Misic-Bouhlel/Projet-Arduino/README.md

# Projet-Arduino
Projet Arduino Bouhlel Ziad/Misic Luka
