Misic-Bouhlel/Projet-Arduino/Cahier des charges/Cahier-des-charges.md

Sous-répertoire contenant le cahier des charges
