Misic-Bouhlel/Projet-Arduino/RAPPORT_FINAL_BOUHLEL_MISIC.pdf

MISIC Luka
BOUHLEL Ziad

# Rapport de projet – Arduino

2021-2022

# Smart Breakfast

## Réalisé par : MISIC Luka & BOUHLEL Ziad

## Encadré par : Pascal MASSON

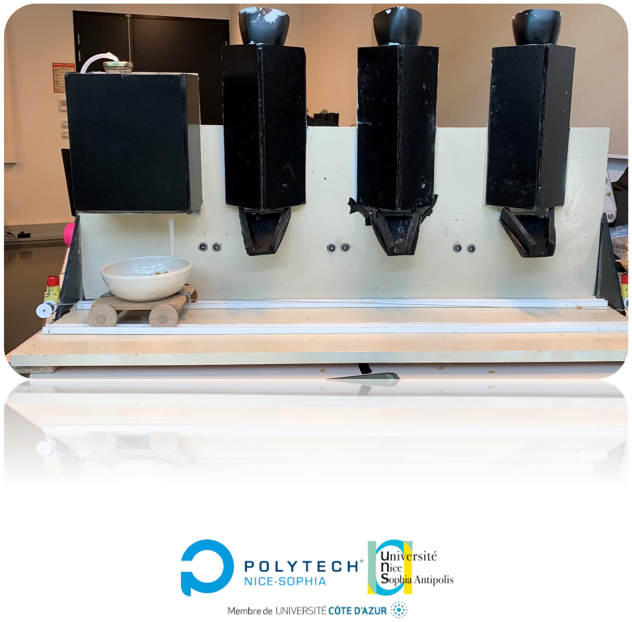
[picture p1: figure]

## SOMMAIRE

## I. Présentation du projet____________________________3

## a) Objectifs et motivations _________________________3

## b) Fonctionnalités : _______________________________3

## c) Matériels utilisés_______________________________3

## II- Réalisation _____________________________________5

## a) Programmation des mécanismes __________________5

## b) Comparaison planning initial/final_________________6

## c) Difficultés rencontrées __________________________7

## III- Conclusion ____________________________________8

## a) Amélioration possible ___________________________8

## b) Apport de ce projet _____________________________9

## I. Présentation du projet

a) Objectifs et motivations

Dans le cadre du parcours de PeiP2, nous avons pu créer un projet Arduino de sa conception à sa réalisation en ayant carte blanche pour le sujet. Le but de ce projet est de se faire une expérience qui nous servira dans le monde professionnel. Cela nous a permis d’évaluer nos compétences sur plusieurs points et d’avoir un regard extérieur sur la façon dont on a réalisé ce projet.

Il arrive à tout le monde de ne pas avoir le temps ni la motivation de préparer son petit-déjeuner alors que ce premier repas de la journée est considéré comme le plus important. On voulait mettre en corrélation l’importance du petit-déjeuner avec notre projet Arduino.

C’est pourquoi nous sommes partis sur l’idée du petit-déjeuner intelligent, l’objectif étant le suivant : réaliser un distributeur de céréales automatisés qui prépare un petit-déjeuner en fonction des choix que l’utilisateur fait sur son smartphone. Ainsi, il n’y a aucun effort à fournir mis à part le choix de son petit-déjeuner.

b) Fonctionnalités :
- Distribution de lait à l’aide d’une pompe
- Déplacement du bol sur des rails sous les diffèrent compartiments
- Distribution de céréales initié par un système de trappe
- Choix de la composition du bol depuis son smartphone par communication Bluetooth avec une application
c) Matériels utilisés

Carte Arduino Mega2560

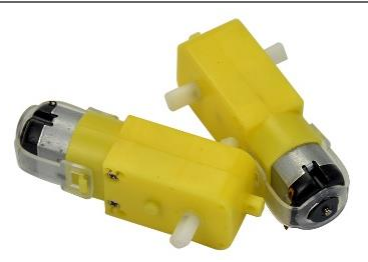
[picture p2: figure]
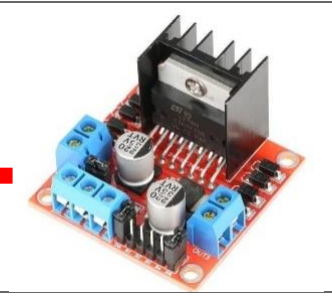
[picture p3: figure]

Moteurs à courant continu + double pont en H : pour le déplacement du bol

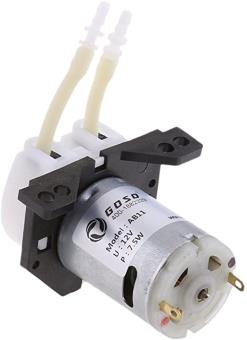
[picture p4: figure]
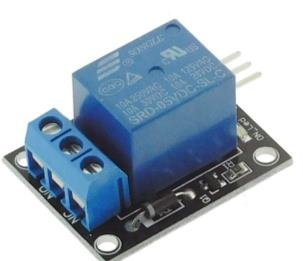
[picture p5: figure]

| Pompe 12V + module relais: pour le versement du lait

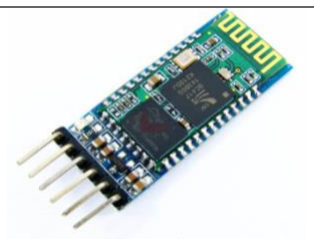
[picture p6: figure]

| Module HC-06 : pour la communication Bluetooth avec le smartphone

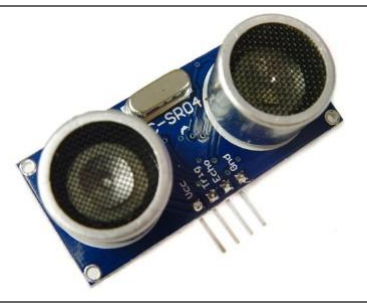
[picture p7: figure]

| Module sonar : pour détecter le bol
| Servomoteurs : pour le versement des céréales
| Alimentation 12V

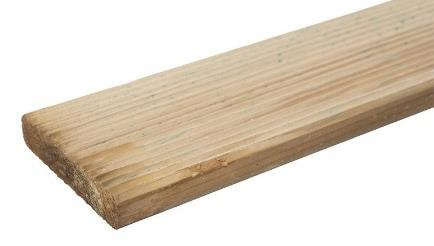
[picture p8: figure]

| Bois : pour la structure, les compartiments

## II- Réalisation

a) Programmation des mécanismes
- Code des servomoteurs :

Pour réaliser le versement des céréales automatiques, il a fallu programmer les servomoteurs afin que leur angle d’ouvertures et de fermeture permettent de d’ouvrir et de recouvrir entièrement la fente sous les compartiments.

- Code de la pompe :

Le relais utilisé nous permet d'activer la pompe pour verser le lait.

- Code du déplacement du bol :

Afin de déplacer le bol sur la structure il a fallu utiliser deux moteurs à courant continu, ils étaient synchronisés pour faire avancer et reculer la plateforme sur laquelle était posé le bol en la tirant par des fils. Lorsqu’un moteur tire, l’autre relâche.

- Code de la communication Bluetooth :

Enfin, pour permettre à l’utilisateur de composer son petit déjeuner sans avoir à manipuler lui-même la structure ou les programmes, nous avons connecté les différents mécanismes à une application sur smartphone : « Bluetooth Electronics ». Pour chaque choix fait sur l’interface, une donnée est envoyée à l’ordinateur qui lui ensuite réalise un enchaînement de conditions déclenchant ou non les mécanismes.

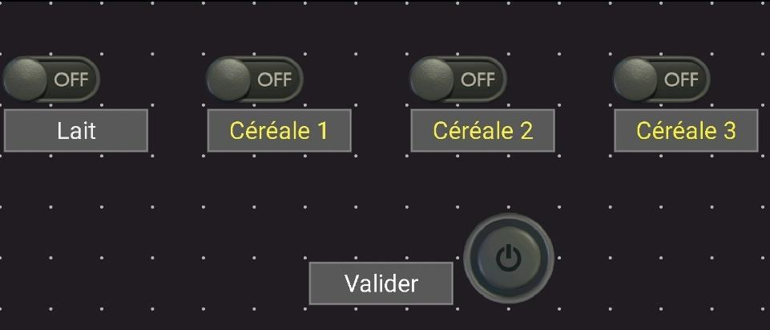
[picture p9: figure]
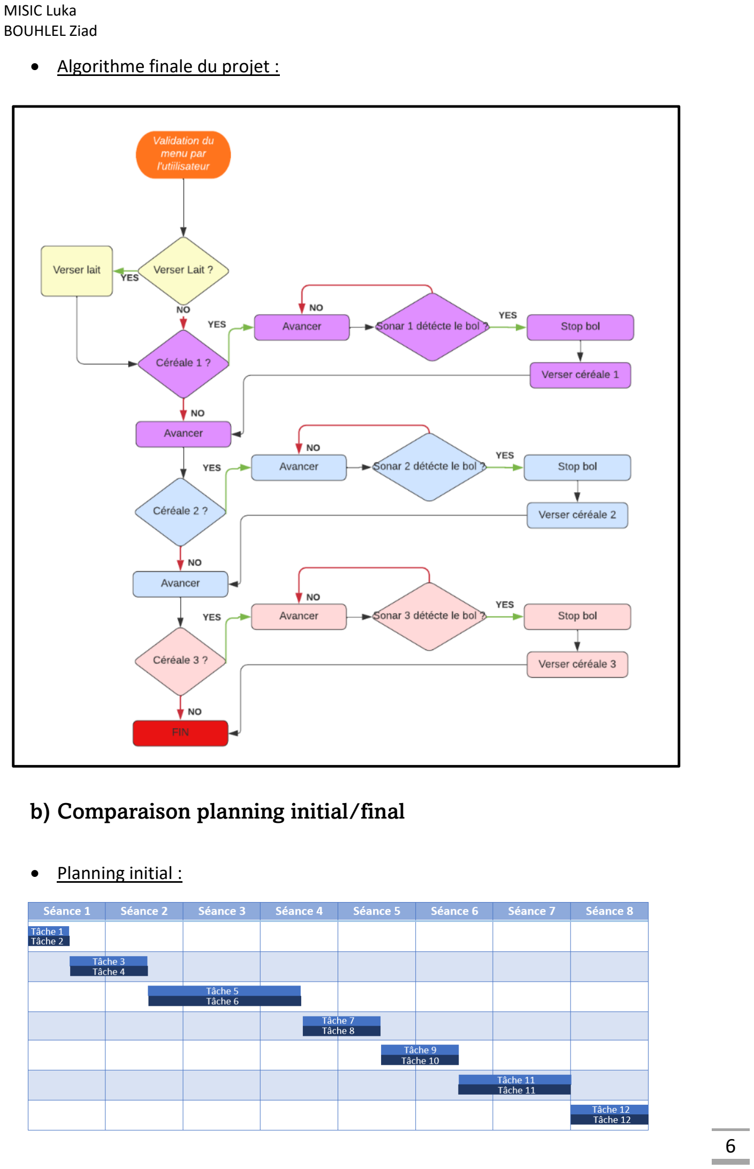
[picture p10: page 6]

- Algorithme finale du projet :
b) Comparaison planning initial/final
- Planning initial :

- Planning final :

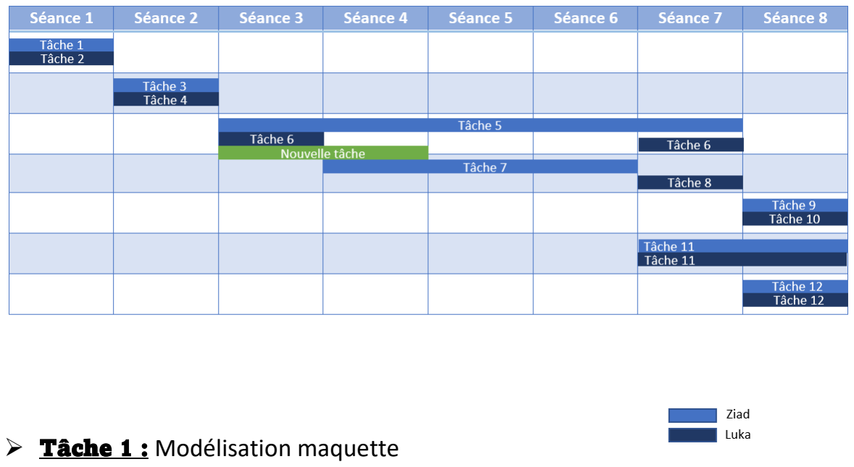
[picture p11: figure]
➢ Tâche 1 : Modélisation maquette

- Tâche 2 : Recherche/achat du matériel
- Tâche 3 : Construction maquette
- Tâche 4 : Test servomoteur + code
- Tâche 5 : Construction/assemblage de la structure finale
- Tâche 6 : Système de versement dans le bol
- Tâche 7 : Déplacement sur les rails du bol
- Tâche 8 : Synchronisation déplacement bol/système de versement
- Tâche 9 : Câble management/insertion de la carte Arduino dans la construction finale
- Tâche 10 : Résolution de problème lié aux programmes/branchements à l’Arduino
- Tâche 11 : Transmission/réception d’information avec smartphone par Bluetooth
- Tâche 12 : Vérification finale/amélioration/Ajout d’options
- Nouvelle tâche : Système de versement du liquide
c) Difficultés rencontrées
- Une des premières difficultés a été la gestion du temps. En effet certaines tâches nous ont pris plus de temps que prévu, en particulier celles liées à la structure.
- Nous avons dû revoir le système de versement car la trappe ne se fermait pas correctement sous le compartiment, nous avons remodélisé le mécanisme puis nous l’avons reconstruit. De plus, certains servomoteurs ne fonctionnaient pas ou faiblement ce qui nous a ralenti davantage.
- Le système de déplacement du bol est la tâche qui nous a pris le plus temps. Il a fallu changer les rails, modifier la plateforme et trouver un moyen de fixer solidement les moteurs qui se décollaient de la structure.
- Enfin, comme nous avions pris du retard sur notre planning, nous avions moins de temps que prévu pour tester la communication Bluetooth. Nous avons tout de même réussi à mettre en place une interface même si elle reste à perfectionner.

## III- Conclusion

a) Amélioration possible
- Le système de versement serait à améliorer en priorité. En effet, le compartiment dans lequel on met les céréales est trop étroit. De plus, la fente dans laquelle les céréales tombent pour se verser dans le bol n’est pas assez large. Le système de versement fonctionne donc seulement avec des céréales de petit diamètre comme des flocons d’avoine mais pas avec des Miels Pops par exemple.
Il faudrait utiliser des bocaux en plastique plus grand et un servomoteur plus performant ou bien utiliser le système d’hélice prévu initialement.
- On pourrait rajouter la possibilité de composer des menus avec des choix prédéfinies ou encore programmer le distributeur afin qu’il prépare un petit-déjeuner à des heures voulues.
- Aussi, il faudrait rajouter une option pour choisir la quantité de céréales souhaitée.
- Enfin, on pourrait également rajouter un bip sonore et une LED indiquant que le bol est prêt.

b) Apport de ce projet

Point de vue de Luka :
Ce projet m’a permis d’acquérir des connaissances et surtout une expérience qui me sera fort utile à l’avenir. J’ai pu évaluer mon comportement sur un projet de plusieurs mois et ainsi voir les choses qui n’allait pas afin de les améliorer (notamment sur la gestion du temps). Ce projet a été une occasion pour moi de travailler en binôme. Il fallait se répartir les tâches et parfois on ne pouvait pas continuer tant que l’autre n’avait pas avancer. Ainsi, le travail en autonomie devait être de qualité pour ne pas se retarder.

Point de vue de Ziad :
Ce projet a été une expérience très enrichissante, en effet j’ai acquis de nouvelles connaissances dans plusieurs domaines. Tout d’abord, en électronique, j’ai pu assimiler de nombreux réflexes de codage et de branchements qui me seront très utiles tout au long de mes études d’ingénieurs. La construction de la structure m’a aussi donné l’occasion d’essayer différents outils de bricolage demandant plus ou moins de maitrise. Le travail en équipe fut également essentiel pour être efficace et optimisé les séances. De plus, créer un projet de la conception à la réalisation nous a mis face à de nombreux problèmes, il fallait remettre en question notre travail à tout moment pour pouvoir avancer.

Enfin, nous tenons à remercier Mr Masson et toute l’équipe enseignante pour nous avoir aidés tout au long de ce projet et de nous avoir fournir le matériel nécessaire à sa réalisation.
