Misic-Bouhlel/Projet-Arduino/Rapport-de-séances/Rapport de séance BOUHLEL/RAPPORT DE SEANCE 8 BOUHLEL G4.pdf

## RAPPORT DE SEANCE : 03/02/2022

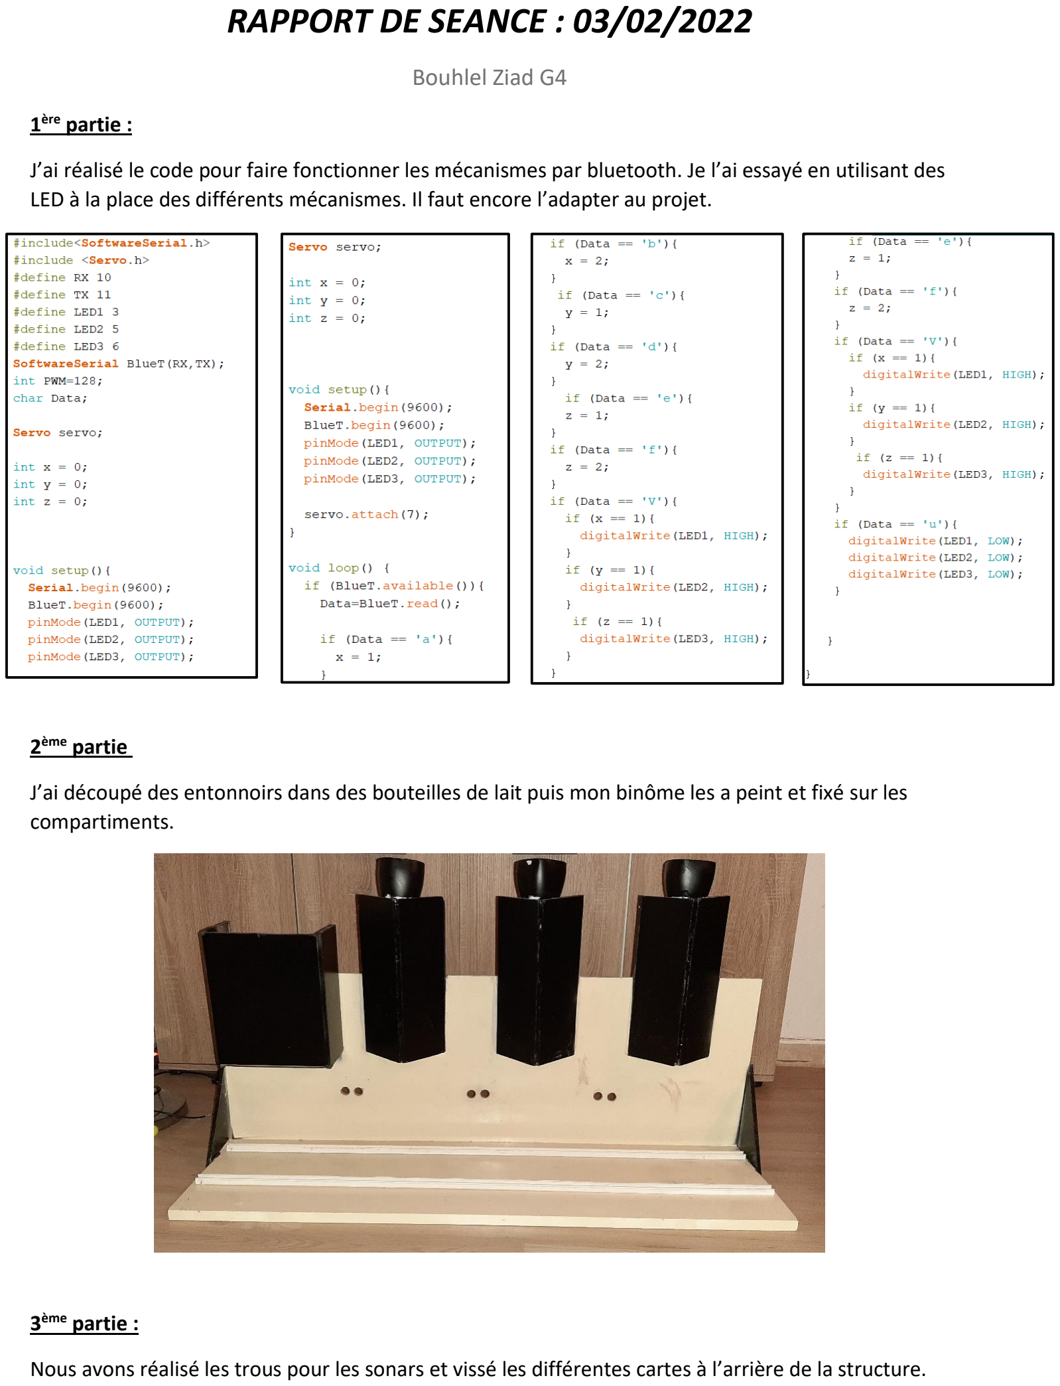
[picture p12: page 1]

Bouhlel Ziad G4

1

ère partie :

J’ai réalisé le code pour faire fonctionner les mécanismes par bluetooth. Je l’ai essayé en utilisant des LED à la place des différents mécanismes. Il faut encore l’adapter au projet.

2

ème partie

J’ai découpé des entonnoirs dans des bouteilles de lait puis mon binôme les a peint et fixé sur les compartiments.

3

ème partie :

Nous avons réalisé les trous pour les sonars et vissé les différentes cartes à l’arrière de la structure.

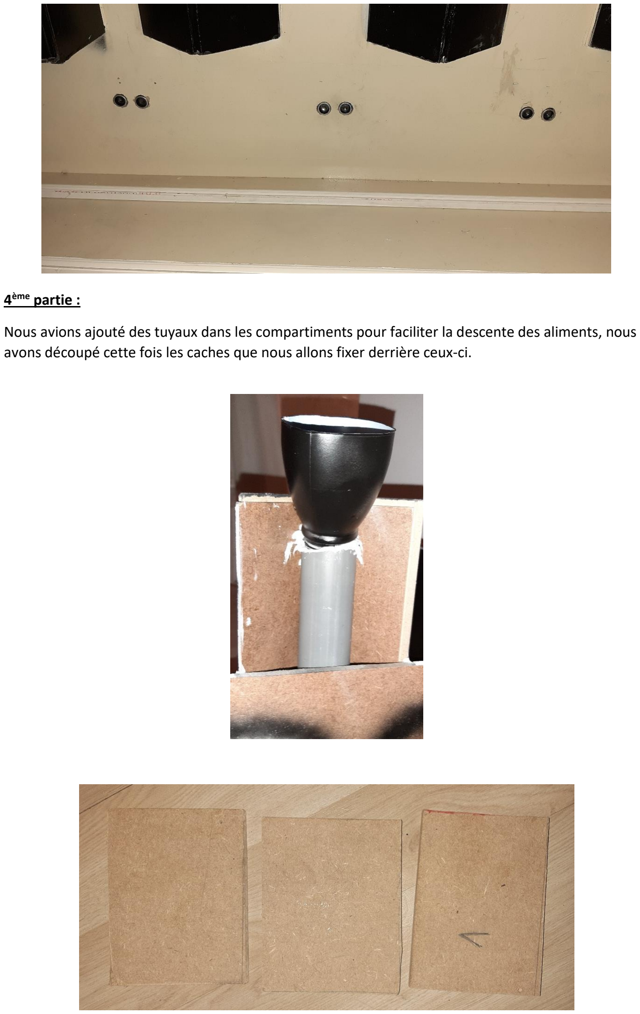
[picture p13: page 2]

4

ème partie :

Nous avions ajouté des tuyaux dans les compartiments pour faciliter la descente des aliments, nous avons découpé cette fois les caches que nous allons fixer derrière ceux-ci.
