Misic-Bouhlel/Projet-Arduino/Rapport-de-séances/Rapport de séance MISIC/Rapport_de_séance_n8_MISIC_G4.pdf

MISIC Luka | G4

## Rapport de séance n°8 (03/03)

✓ Customisation

J’ai laissé place à mon âme d’artiste pour apporter de la couleur à ce bois terne et fade. Je vous laisse donc contempler ce duo de couleur apportant à la fois modernité et sobriété. Michelangelo n’a qu’à bien se tenir…

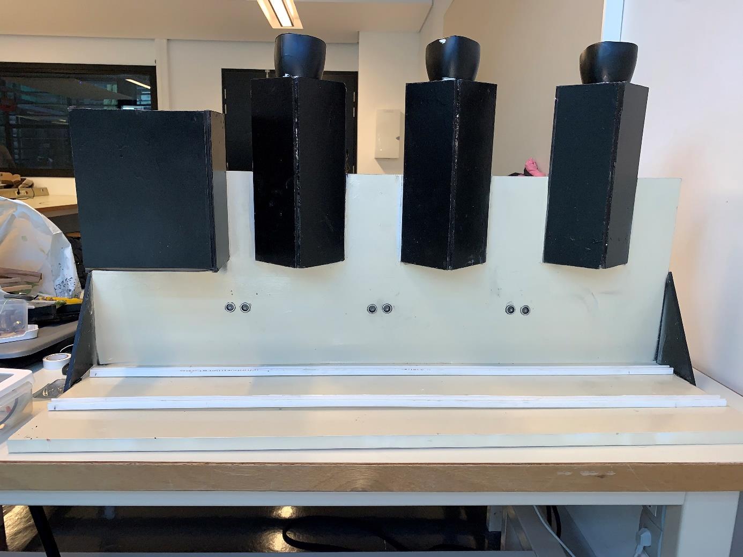
[picture p14: figure]

✓ Entonnoir

Je me suis chargé d’ajouter des entonnoirs dans les compartiments afin que les céréales tombent bien dans le trou du compartiment et ne restent pas bloqués sur les côtés. Voici une vue de côté :

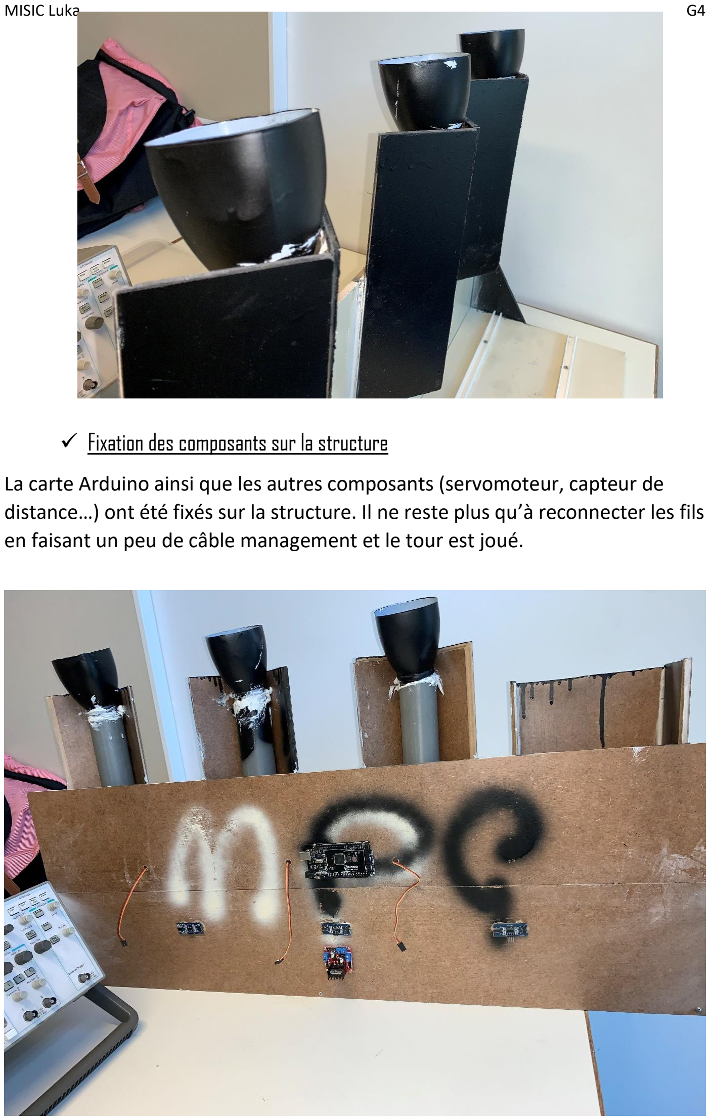
[picture p15: page 2]

✓ Fixation des composants sur la structure

La carte Arduino ainsi que les autres composants (servomoteur, capteur de distance…) ont été fixés sur la structure. Il ne reste plus qu’à reconnecter les fils en faisant un peu de câble management et le tour est joué.

✓ Rampe

La semaine dernière j’étais parti sur l’idée de faire les rampes pour les céréales avec un tube PVC coudé. Le problème étant qu’avec ce tube ça n’aurait pas été pratique. J’ai donc réalisé les rampes avec du bois (voir photo ci-dessous) :

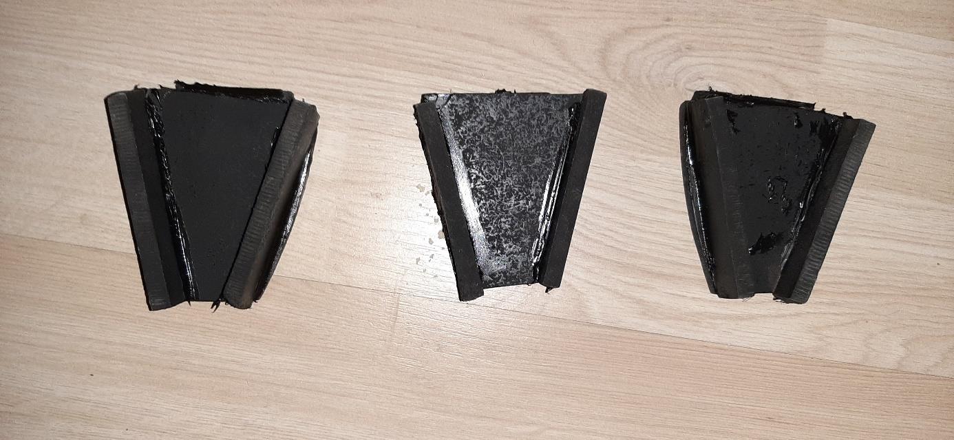
[picture p16: figure]

Ainsi il suffira de les coller sur la structure et sous les compartiments afin que les céréales soient directement dirigées dans le bol.

✓ Code

Pour le code du déplacement du bol j’ai simplement crée 3 fonctions : avancer(), reculer() et arreter(). Ces fonction seront appelées lorsque le sonar détectera le bol afin que ce dernier se place en dessous des compartiments.

Voici un exemple d’utilisation :

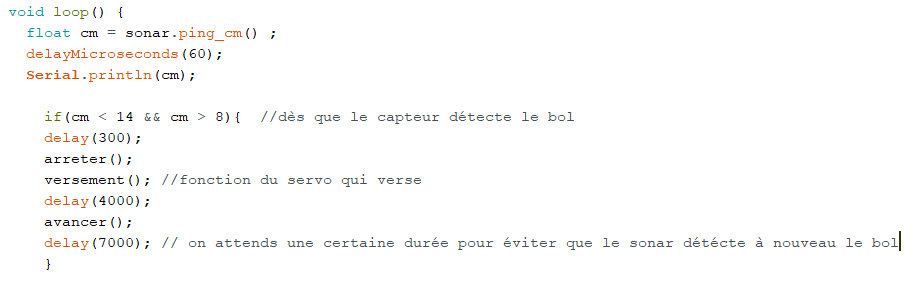
[picture p17: figure]

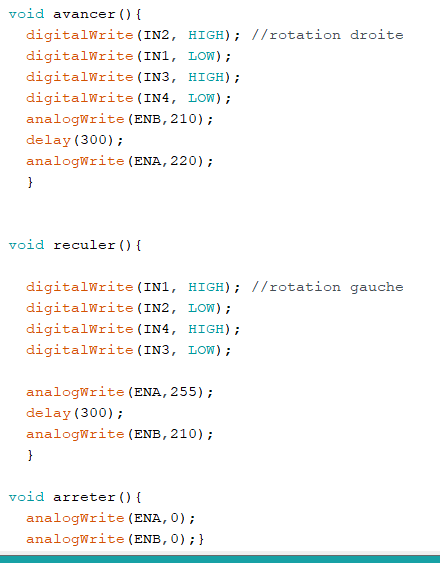
[picture p18: figure]

Il reste à finir le code avec le Bluetooth et de l’implemanter dans le code principal avec les autres fonctions.
