Misic-Bouhlel/Projet-Arduino/Rapport-de-séances/Rapport de séance BOUHLEL/RAPPORT DE SEANCE 7 BOUHLEL G4.pdf

## RAPPORT DE SEANCE : 24/02/2022

Bouhlel Ziad G4

1

ère partie :

Nous avons décidé de revoir le système de trappe, le précédent n’était pas assez solide.

J’ai modélisé en 3D le nouveau système puis je l’ai fabriqué en bois.

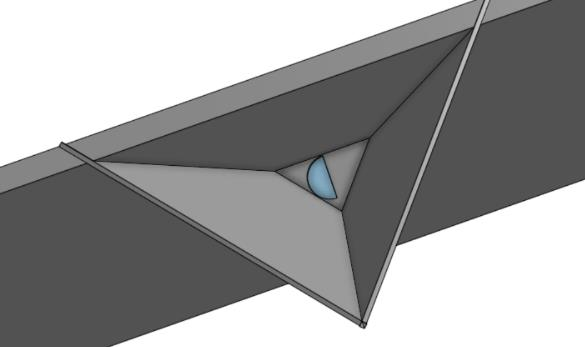
[picture p19: figure]
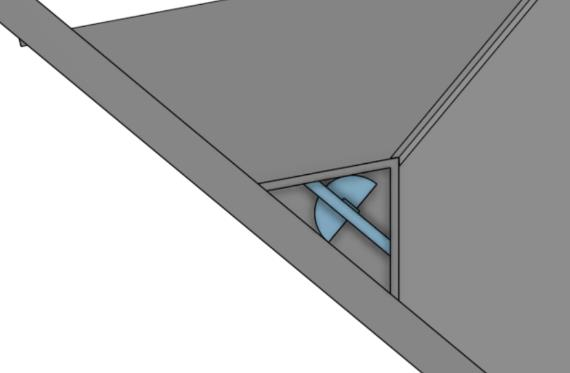
[picture p20: figure]

La trappe est maintenant en forme de demi-cercle et subi une rotation pour fermer le compartiment.

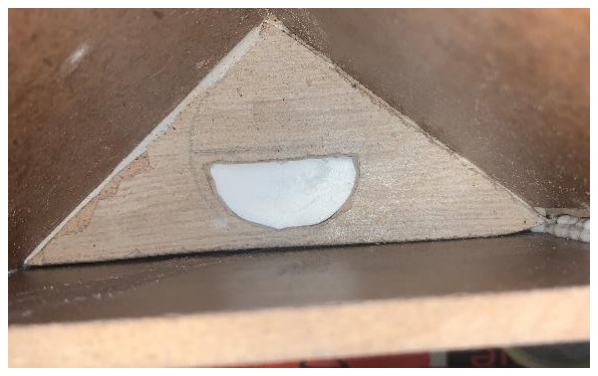
[picture p21: figure]
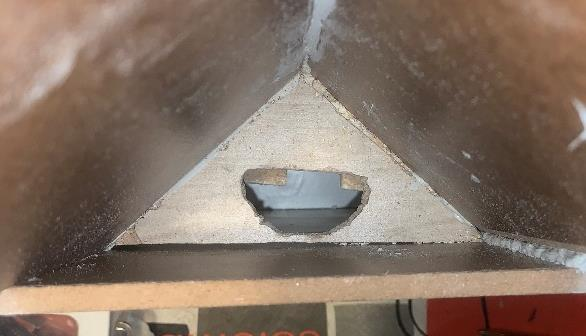
[picture p22: figure]

Vue du dessus Trappe ouverte | Trappe fermée

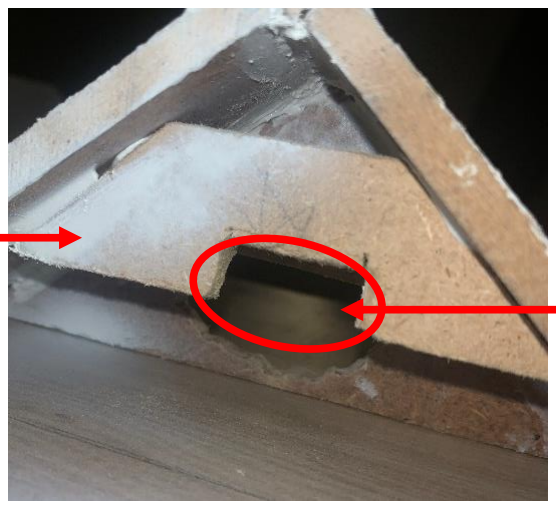
[picture p23: figure]

Vue du dessous

Support du
servomoteur
Emplacement du
servomoteur

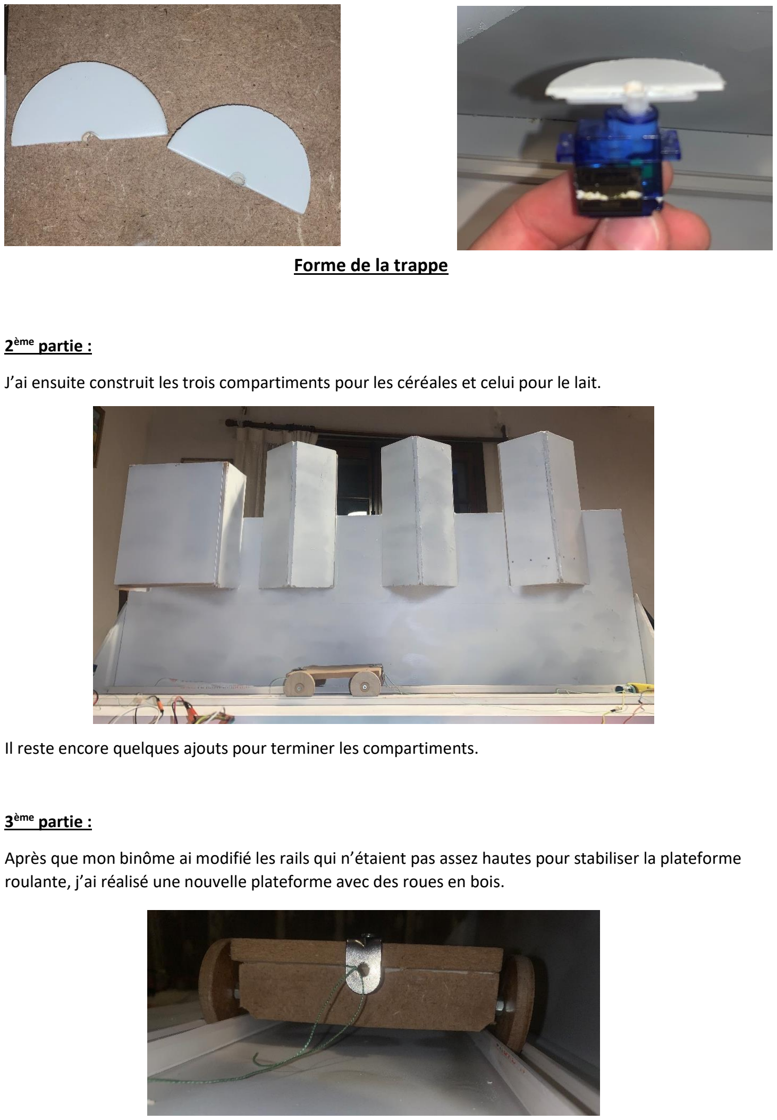
[picture p24: page 2]

2

ème partie :

J’ai ensuite construit les trois compartiments pour les céréales et celui pour le lait.

Il reste encore quelques ajouts pour terminer les compartiments.

3

ème partie :

Après que mon binôme ai modifié les rails qui n’étaient pas assez hautes pour stabiliser la plateforme roulante, j’ai réalisé une nouvelle plateforme avec des roues en bois.

Forme de la trappe

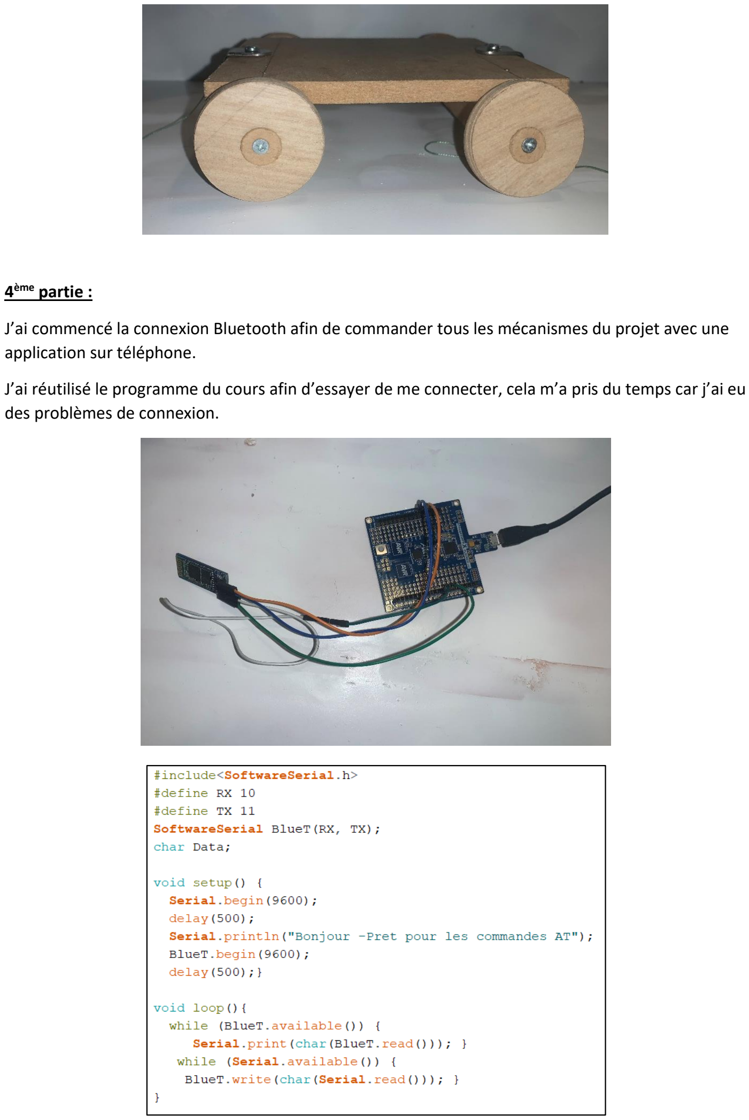
[picture p25: page 3]

4

ème partie :

J’ai commencé la connexion Bluetooth afin de commander tous les mécanismes du projet avec une application sur téléphone.

J’ai réutilisé le programme du cours afin d’essayer de me connecter, cela m’a pris du temps car j’ai eu des problèmes de connexion.

Conclusion :

Nous avons presque terminé la structure, il faut encore ajouter quelques supports en bois et la carte Arduino à visser sur la structure. Avant la prochaine séance il va falloir peindre la structure et avancer sur la connexion Bluetooth également.
