Misic-Bouhlel/Projet-Arduino/Rapport-de-séances/Rapport de séance MISIC/Rapport_de_séance_n6_MISIC_G4.pdf

MISIC Luka | G4

## Rapport de séance n°6 (10/02)

✓ Système de déplacement du bol : plateforme

J’ai été confronté à plusieurs problèmes dont un a été celui de la plateforme, là où sera poser le bol. En effet, il y’avait trop de jeu au niveau des fixations des roues car le bois s’effritait et donc les vis qui fixaient les roues n’étaient pas stables. J’ai donc changé cette partie de la plateforme avant d’y fixer de nouveau les roues et le tour était joué. Cela nous a quand même pris un certain temps dû à notre manque de dextérité avec les outils utilisées.

J’ai ensuite, toujours avec l’aide de mon binôme, fixé deux crochets sur la partie avant et arrière de la plateforme pour pouvoir y attacher les fils tracteurs. Après toutes les modifications, voici comment est la plateforme :

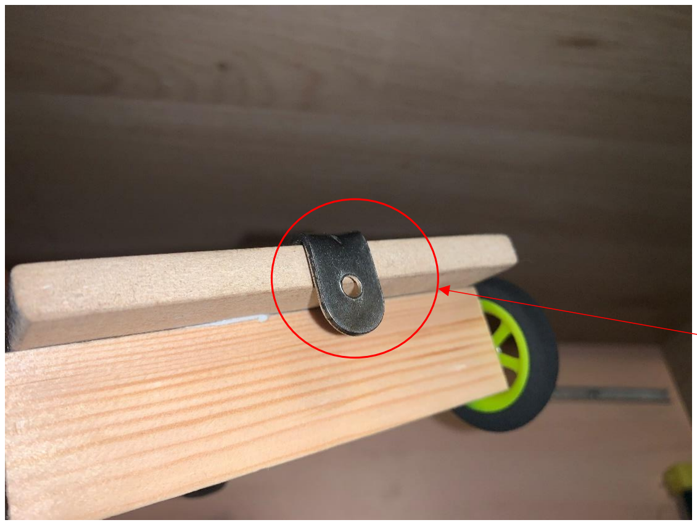
[picture p37: figure]

Crochet

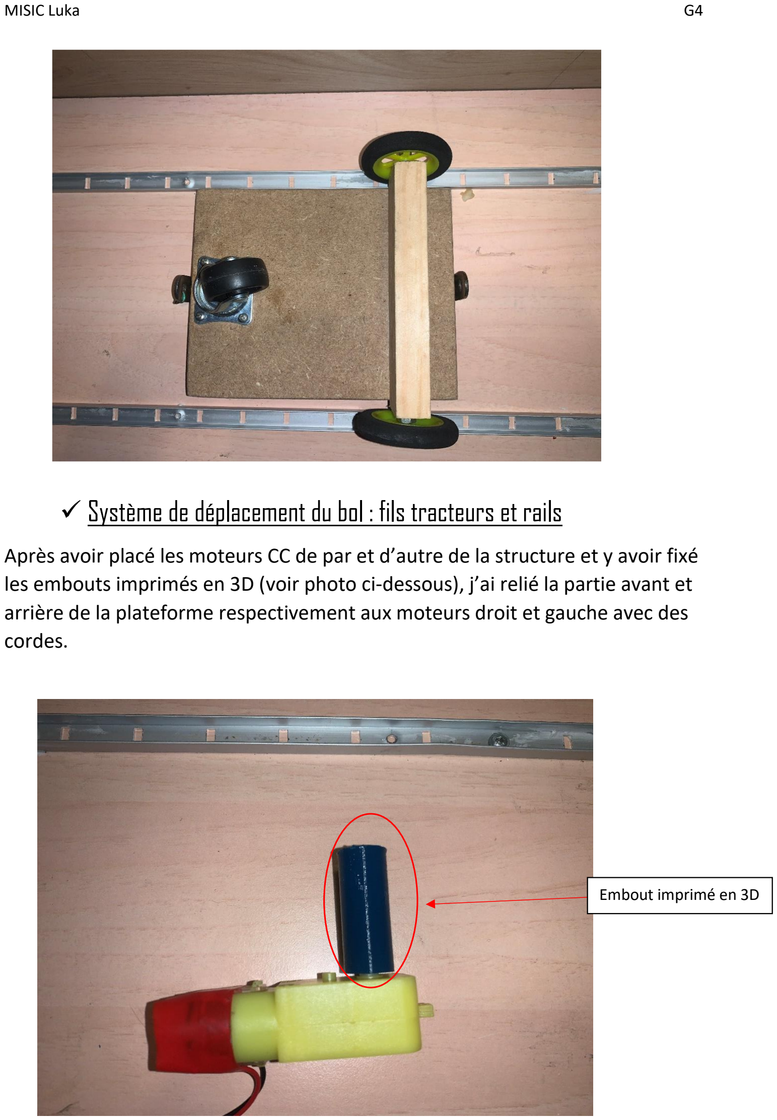
[picture p38: page 2]

### ✓ Système de déplacement du bol : fils tracteurs et rails

Après avoir placé les moteurs CC de par et d’autre de la structure et y avoir fixé les embouts imprimés en 3D (voir photo ci-dessous), j’ai relié la partie avant et arrière de la plateforme respectivement aux moteurs droit et gauche avec des cordes.

Embout imprimé en 3D

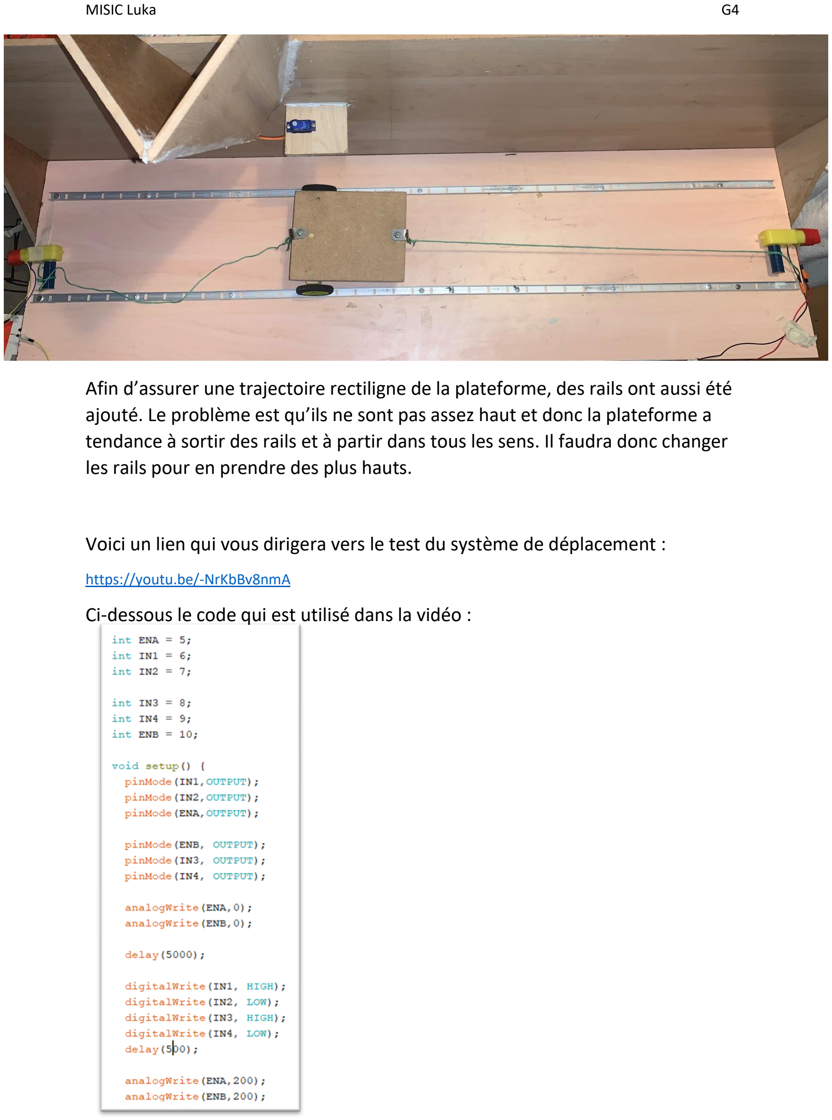
[picture p39: page 3]

Afin d’assurer une trajectoire rectiligne de la plateforme, des rails ont aussi été ajouté. Le problème est qu’ils ne sont pas assez haut et donc la plateforme a tendance à sortir des rails et à partir dans tous les sens. Il faudra donc changer les rails pour en prendre des plus hauts.

Voici un lien qui vous dirigera vers le test du système de déplacement :

https://youtu.be/-NrKbBv8nmA
Ci-dessous le code qui est utilisé dans la vidéo :

Objectif de la séance : synchronisation système de versement/bol + fixation de tous les composants + commencer la transmission/réception d’informations avec smartphone par Bluetooth (si le temps le permet)→ RETARD
Objectif de la prochaine séance : rattraper tout le retard.
