Misic-Bouhlel/Projet-Arduino/Rapport-de-séances/Rapport de séance BOUHLEL/RAPPORT DE SEANCE 4 BOUHLEL G4.pdf

## RAPPORT DE SEANCE : 10/01/2022

Bouhlel Ziad G4

Hors séance :

Nous avons continué la fabrication de la structure : assemblage des différentes parties, ajout d’équerre pour solidifier la structure.

Nous avons ensuite découpé un compartiment à céréale que nous avons collé sur la structure (il y en aura au total trois plus le distributeur de lait). Nous avons réalisé une fente dans le compartiment pour soutenir la trappe du servomoteur. Enfin nous avons collé le support pour le servomoteur pour que la trappe puisse fonctionner sans difficulté. Toutefois après quelques tests nous avons eu quelques éléments à améliorer sur le système de la trappe.

Voici à quoi ressemble notre projet pour le moment :

1

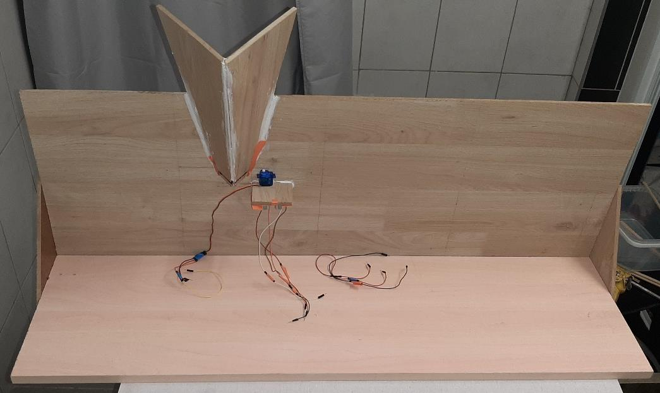
[picture p42: figure]

ère partie de séance :

Pendant cette séance j’ai réalisé le code pour tester la pompe à liquide que nous allons utiliser pour le projet.

J’ai utilisé un relais pour relier la pompe à la carte Arduino :

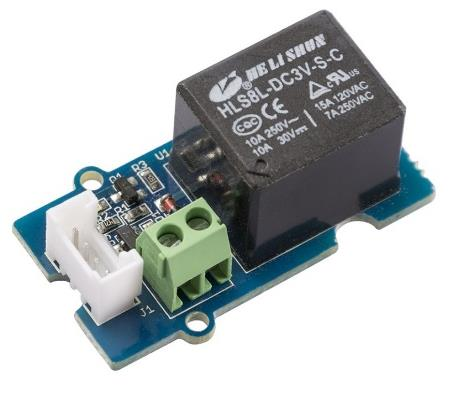
[picture p43: figure]

J’ai réalisé le code suivant afin de faire fonctionner le relais.

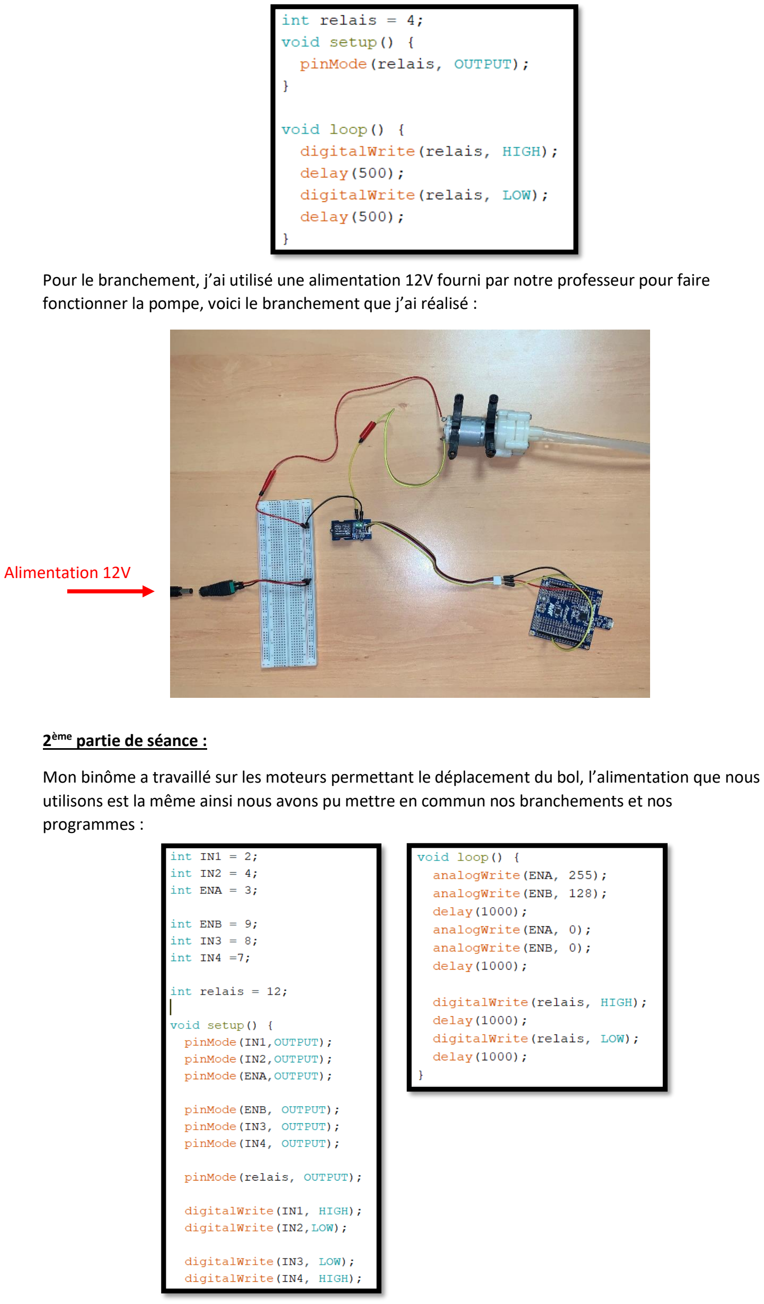
[picture p44: page 2]

Pour le branchement, j’ai utilisé une alimentation 12V fourni par notre professeur pour faire fonctionner la pompe, voici le branchement que j’ai réalisé :

2

ème partie de séance :

Mon binôme a travaillé sur les moteurs permettant le déplacement du bol, l’alimentation que nous utilisons est la même ainsi nous avons pu mettre en commun nos branchements et nos programmes :

Alimentation 12V

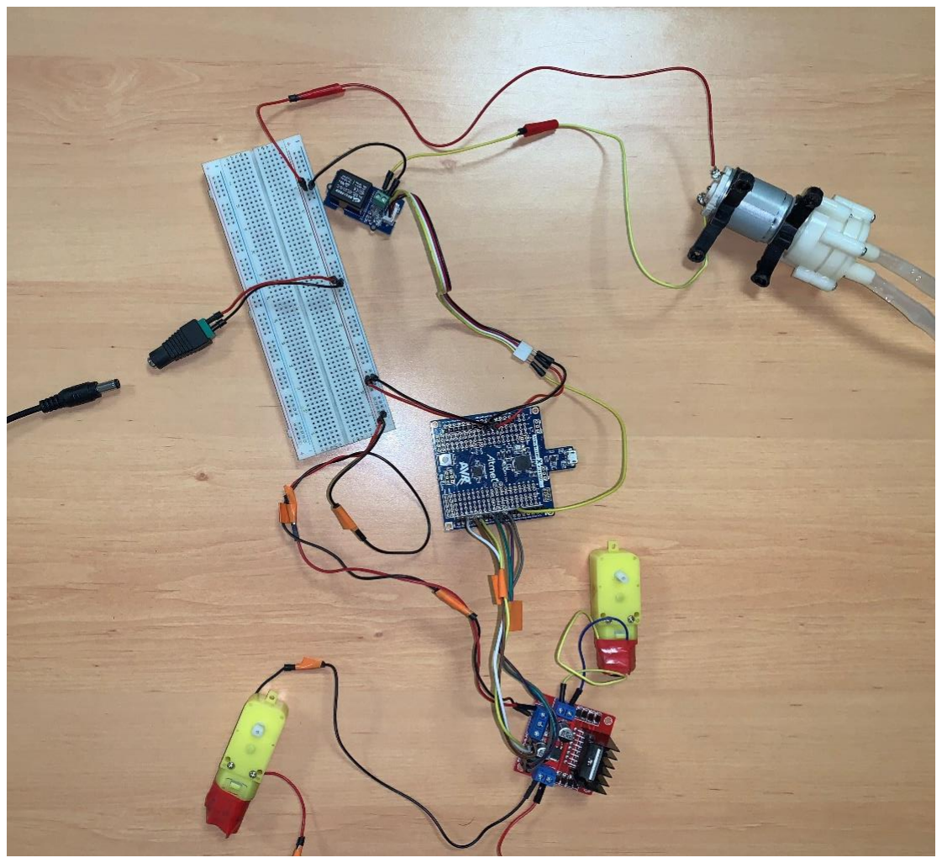
[picture p45: figure]

Conclusion :

Ainsi, durant cette séance nous avons pu présenter notre avancement au professeur et terminer plusieurs programmes de notre projet.

Pour les prochaines séances nous allons devoir ajouter les différentes parties manquantes à la structure et terminer le déplacement du bol.
