Misic-Bouhlel/Projet-Arduino/Rapport-de-séances/Rapport de séance BOUHLEL/RAPPORT DE SEANCE 1 BOUHLEL G4.pdf

## RAPPORT DE SEANCE : 06/12/2021

Bouhlel Ziad G4

1

ère partie de séance :

J’ai modélisé sur le site OnShape : https://www.onshape.com/ la structure de notre projet, cela m’a permis de réfléchir sur les dimensions que nous allons utiliser pour la réalisation finale.

On retrouve les socles pour les bocaux rattachés à une structure en bois.

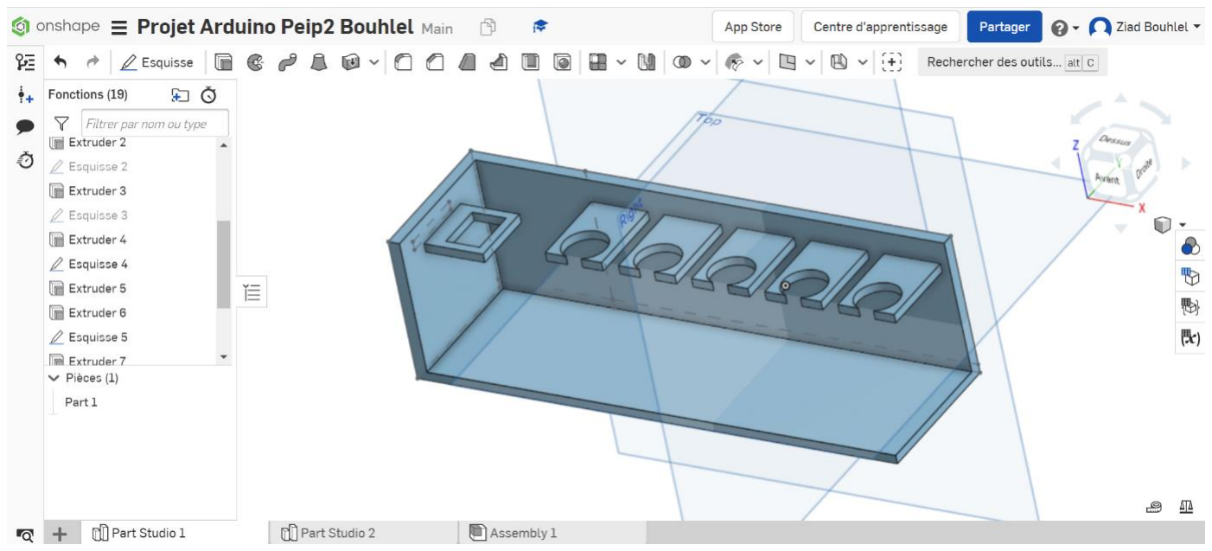
[picture p55: figure]

2

ème partie de séance :

Nous avons discuté avec Mr. Masson sur les différents dispositifs que l’on pouvait utiliser pour optimiser le distributeur et le temps de travail.

Tout d’abord nous avons revu le système d’hélice qui permettait de faire tomber les céréales, nous avons finalement opté pour un système de trappe plus simple à mettre en place.

Nous avons également modifié le mode de déplacement du bol, nous n’allons pas utiliser des rails mais un système de courroie faisant se déplacer le bol sur une plateforme roulante.

L’ajout d’un dispositif pour verser un liquide dans le bol a été introduit dans le projet principal, pour cela nous allons utiliser une pompe.

3

ème partie de séance :

Après avoir validé ces modifications j’ai remodélisé la structure finale du projet afin d’intégrer les espaces pour les servomoteurs des trappes. Nous n’allons pas utiliser de bocaux mais fabriquer nousmêmes les compartiments pour les aliments afin de s’ajuster par rapport aux trappes.

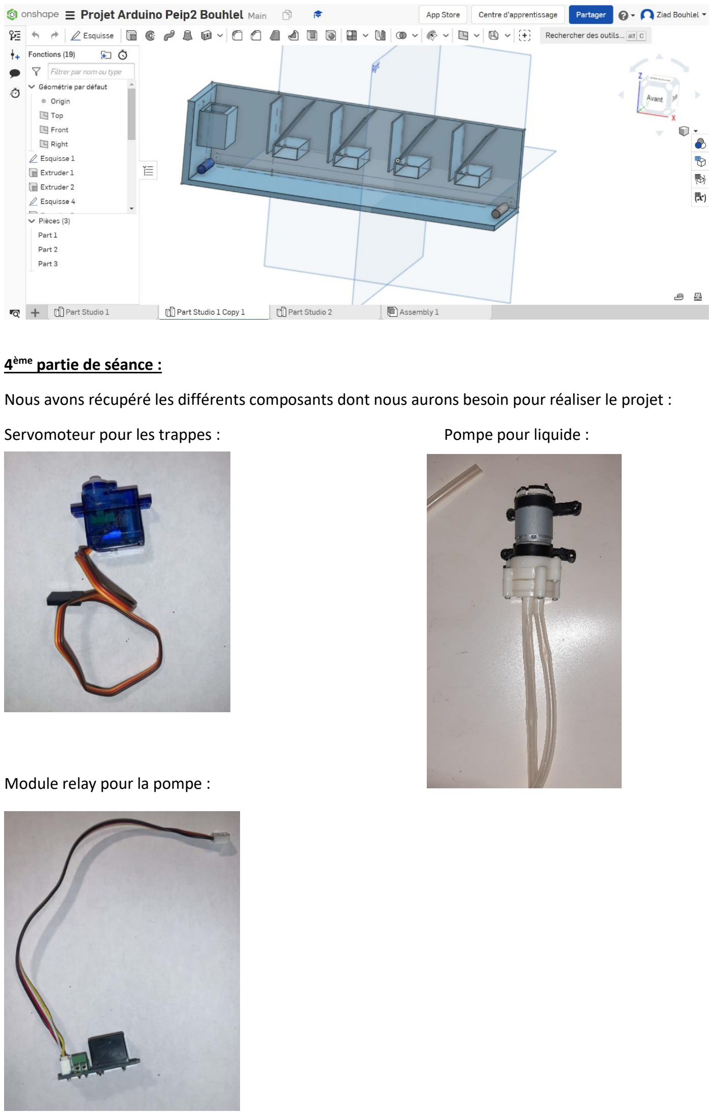
[picture p56: page 2]

4

ème partie de séance :

Nous avons récupéré les différents composants dont nous aurons besoin pour réaliser le projet :

Servomoteur pour les trappes : | Pompe pour liquide :

Module relay pour la pompe :

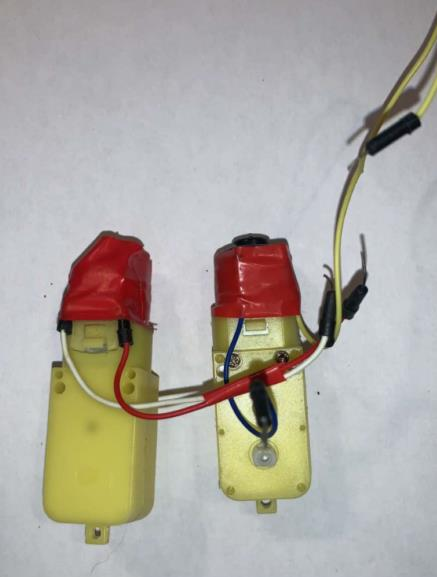
[picture p57: figure]

Moteurs pour la courroie

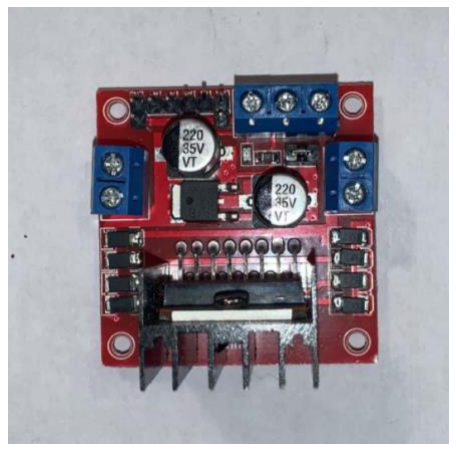
[picture p58: figure]

: | Contrôleur de moteurs pour les deux moteurs à courroie
:
