Misic-Bouhlel/Projet-Arduino/Rapport-de-séances/Rapport-de-séances.md

Sous-répertoire contenant les rapports de séances
