Misic-Bouhlel/Projet-Arduino/Rapport-de-séances/Rapport de séance MISIC/Rapport-de-séance.md

Sous-répertoire contenant les rapports de séances de MISIC Luka
