Misic-Bouhlel/Projet-Arduino/Rapport-de-séances/Rapport de séance BOUHLEL/Rapport-de-séance.md

Sous-répertoire contenant les rapports de séance de BOUHLEL Ziad
