Misic-Bouhlel/Projet-Arduino/Rapport-de-séances/Rapport de séance BOUHLEL/RAPPORT DE SEANCE 5 BOUHLEL G4/Pièce en 3D réalisée.stl

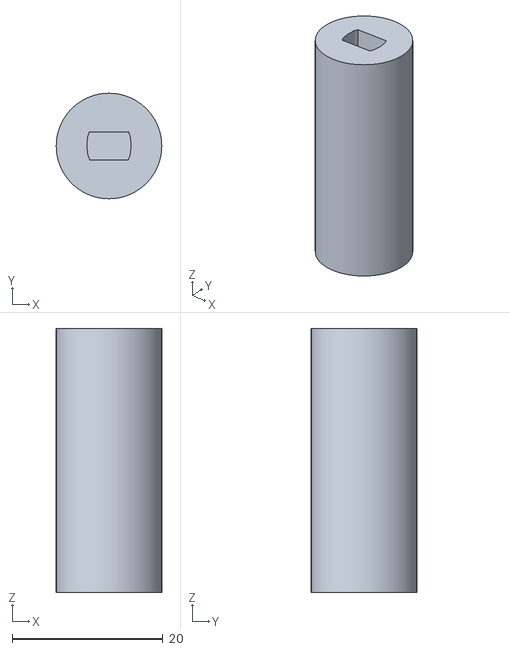
[picture p78: CAD file, 2022-02-04]
Rapport-de-séances/Rapport de séance BOUHLEL/RAPPORT DE SEANCE 5 BOUHLEL G4/Pièce en 3D réalisée.stl
14.0 x 14.0 x 35.0
