Misic-Bouhlel/Projet-Arduino/POWERPOINT_BOUHLEL_MISIC.pdf

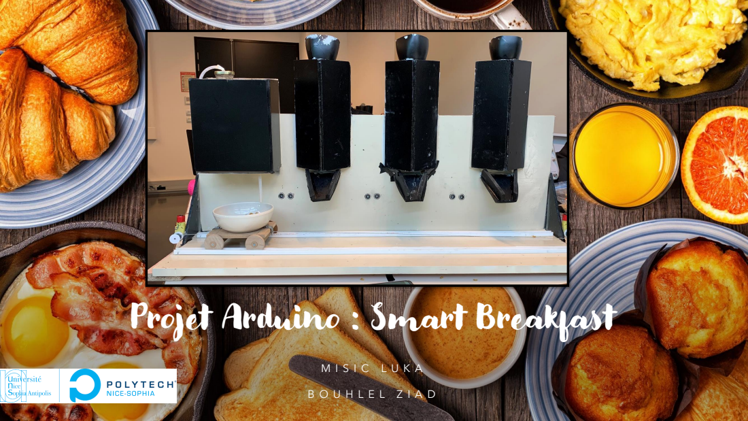
[picture p79: page 1]

Projet Arduino : Smart Breakfast

# Comment optimiser son temps le matin ?

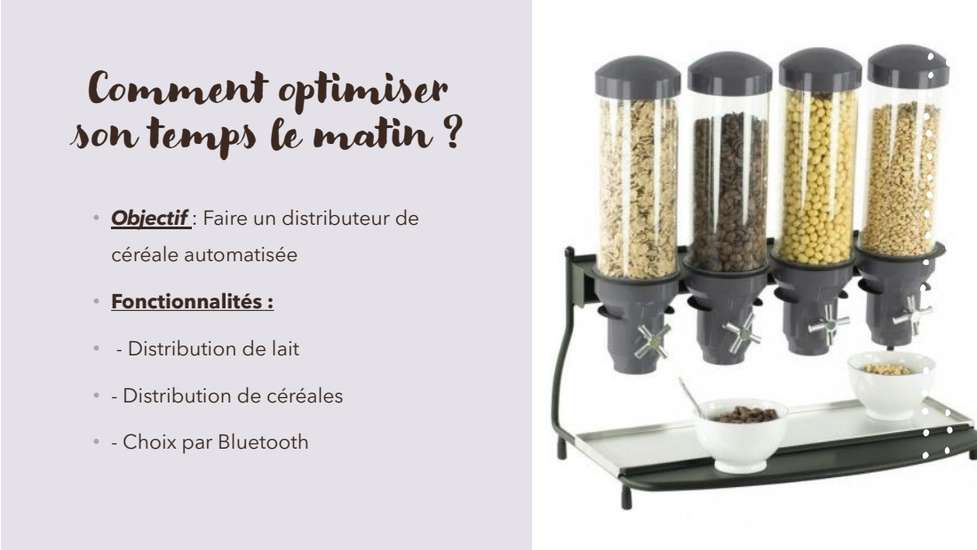
[picture p80: page 2]
• Fonctionnalités :

• Objectif : Faire un distributeur de
céréale automatisée

• - Distribution de lait

• - Distribution de céréales

• - Choix par Bluetooth

# LA STRUCTURE

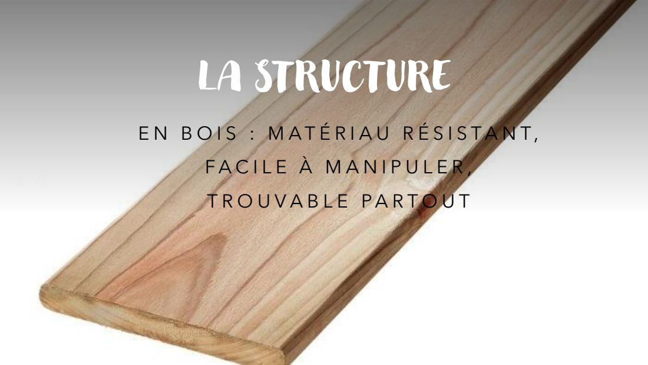
[picture p81: page 3]

# LE DEPLACEMENT

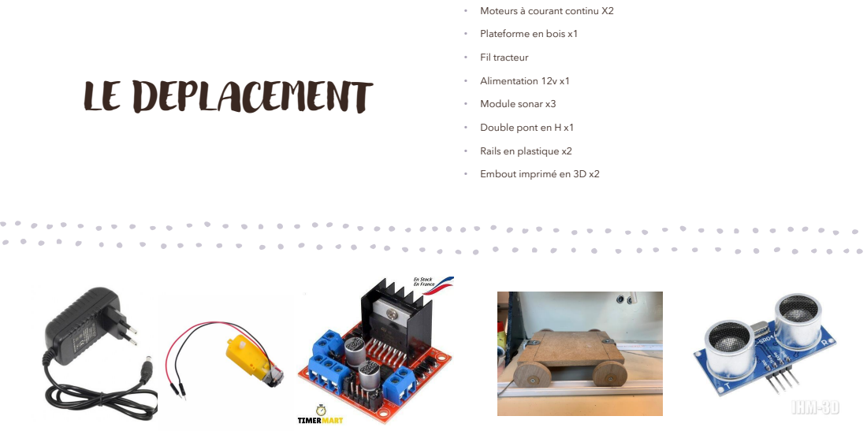
[picture p82: page 4]
• Fil tracteur; • Alimentation 12v x1; • Module sonar x3

• Moteurs à courant continu X2

• Plateforme en bois x1

• Double pont en H x1

• Rails en plastique x2

• Embout imprimé en 3D x2

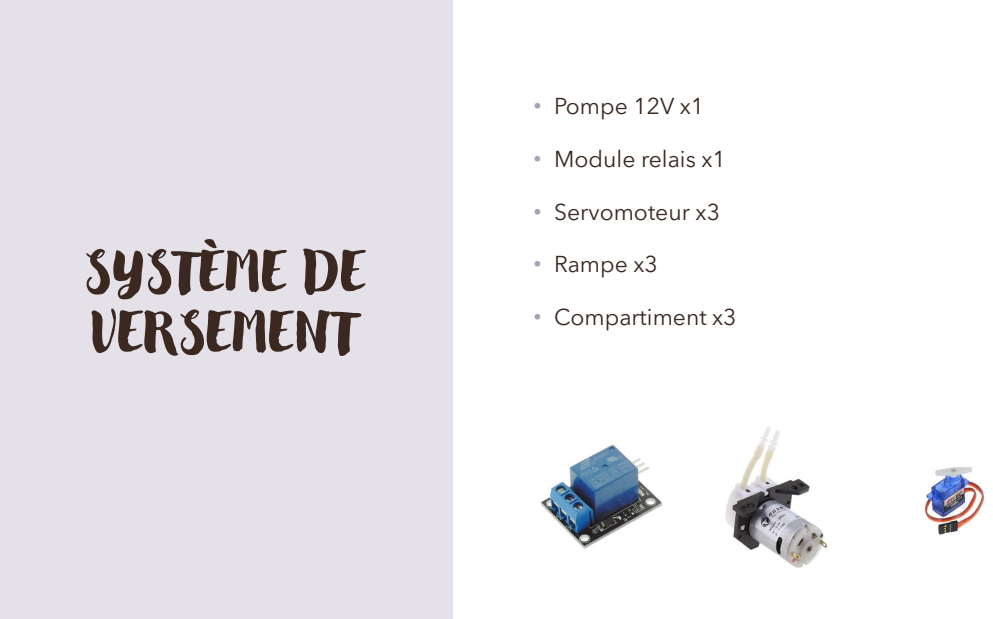
[picture p83: page 5]
SYSTÈME DE VERSEMENT; • Pompe 12V x1; • Module relais x1; • Servomoteur x3; • Rampe x3; • Compartiment x3

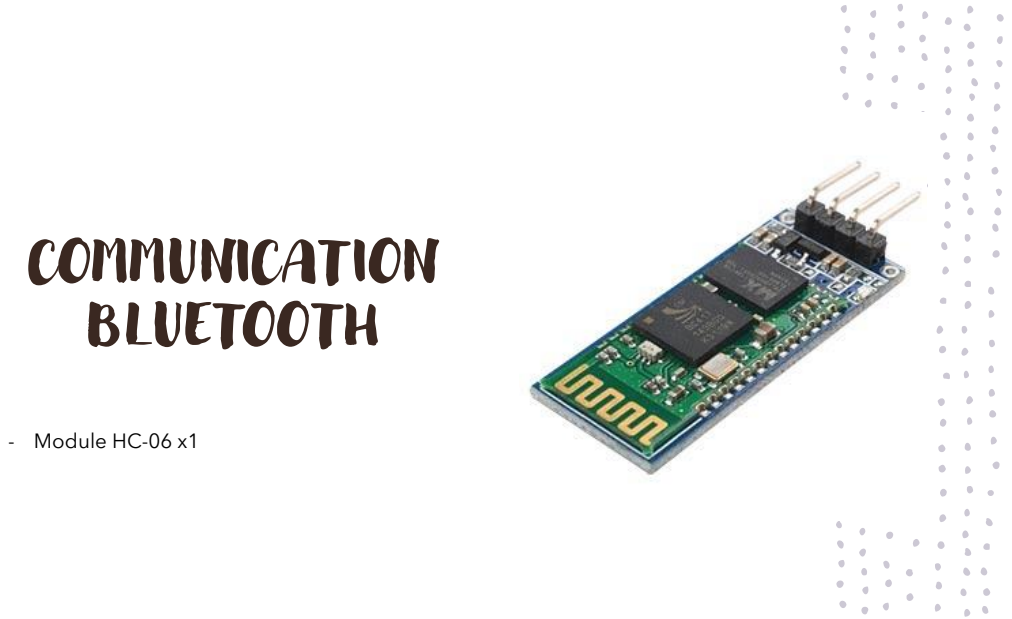
[picture p84: page 6]
COMMUNICATION BLUETOOTH; - Module HC-06 x1

# DIFFICULTES RENCONTREES

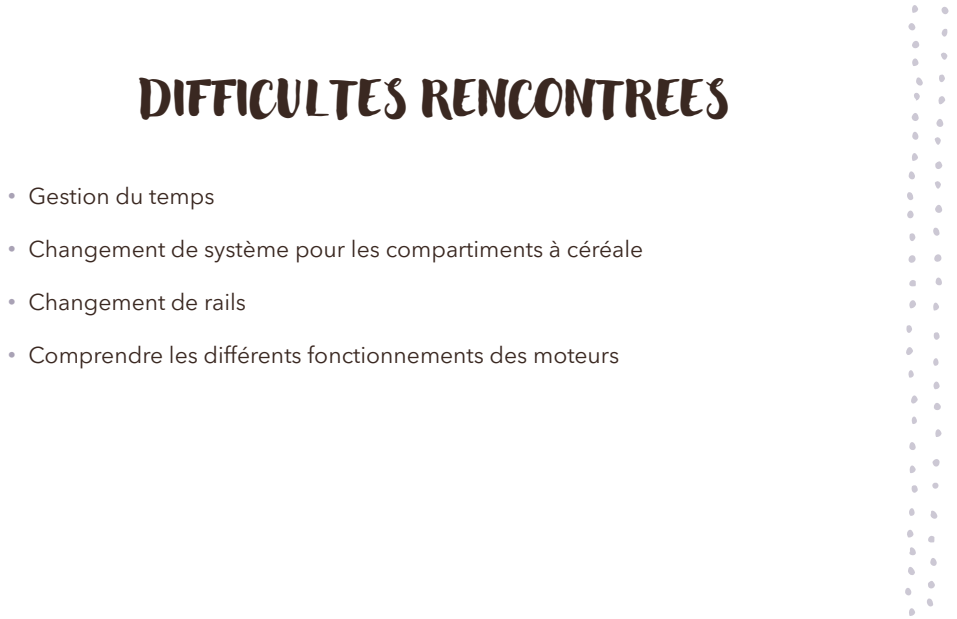
[picture p85: page 7]

• Gestion du temps

• Changement de système pour les compartiments à céréale

• Changement de rails

• Comprendre les différents fonctionnements des moteurs

# PERSPECTIVE D’AMELIORATION

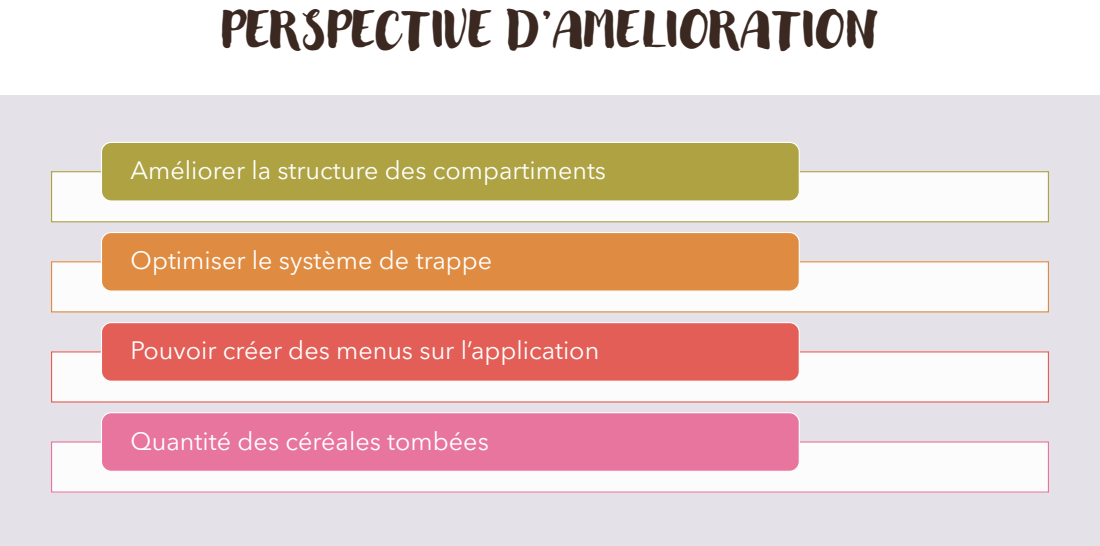
[picture p86: page 8]

Améliorer la structure des compartiments

Optimiser le système de trappe

Pouvoir créer des menus sur l’application

Quantité des céréales tombées

# CONCLUSION

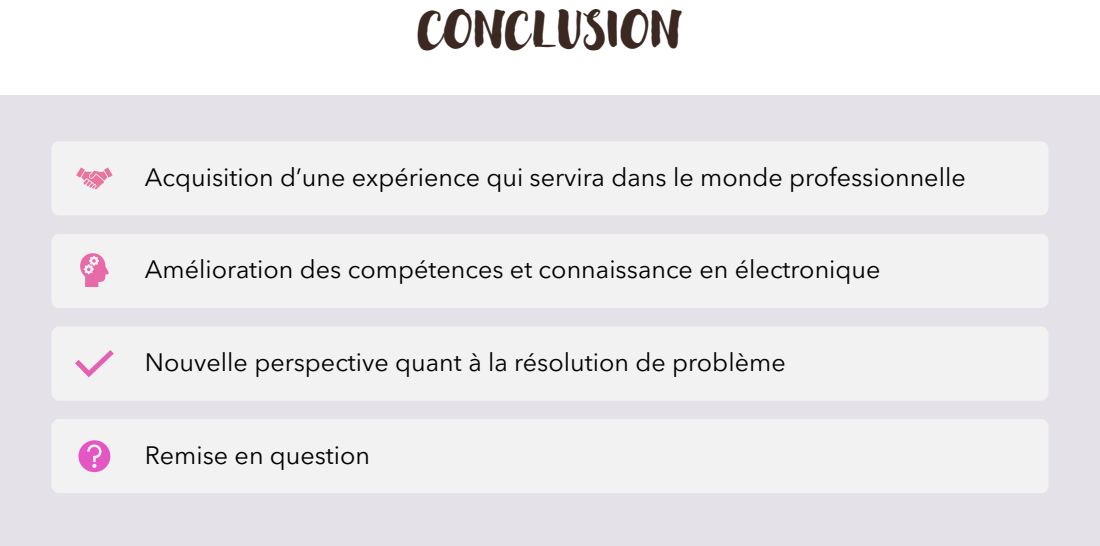
[picture p87: page 9]

Acquisition d’une expérience qui servira dans le monde professionnelle

Amélioration des compétences et connaissance en électronique

Nouvelle perspective quant à la résolution de problème

Remise en question
